evilscientress/ESP32-C3-UWB/hardware/ESP32 UWB bottom.png

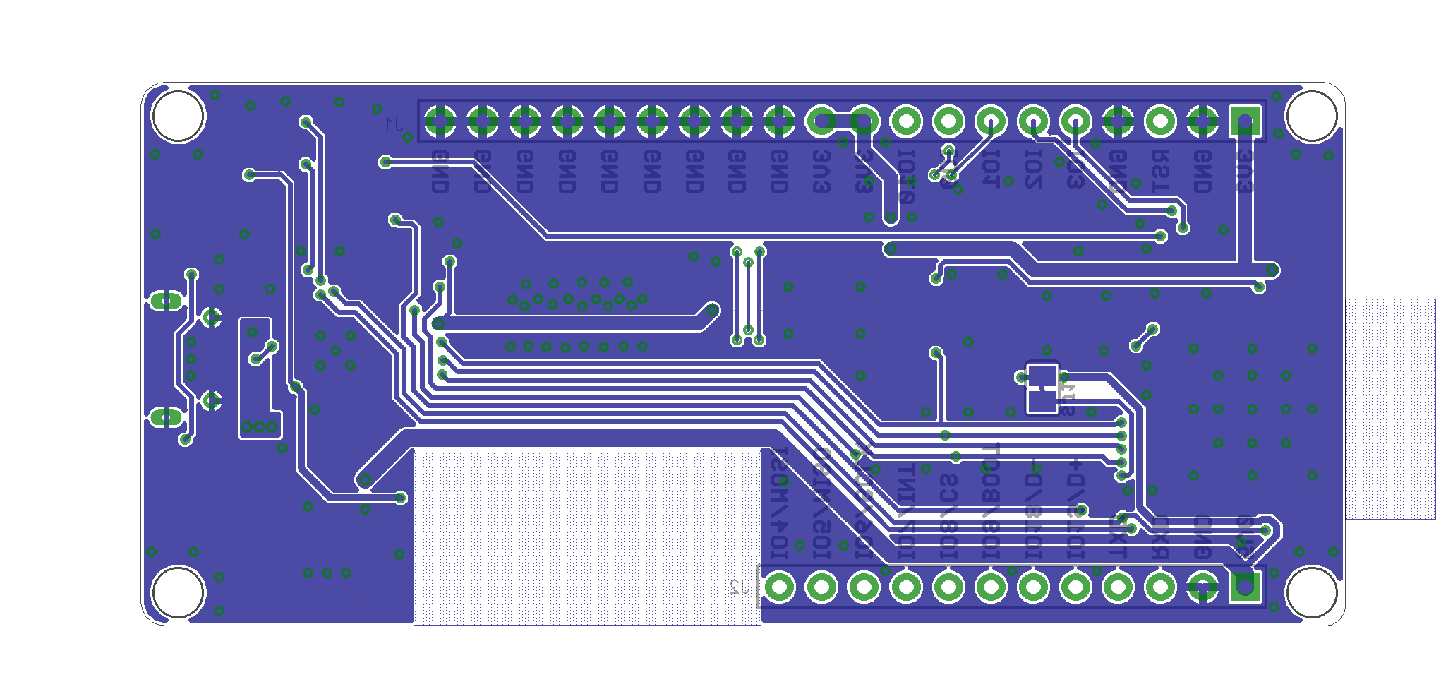
hardware/ESP32 UWB bottom.png
