evilscientress/ESP32-C3-UWB/hardware/ESP32 UWB top.png

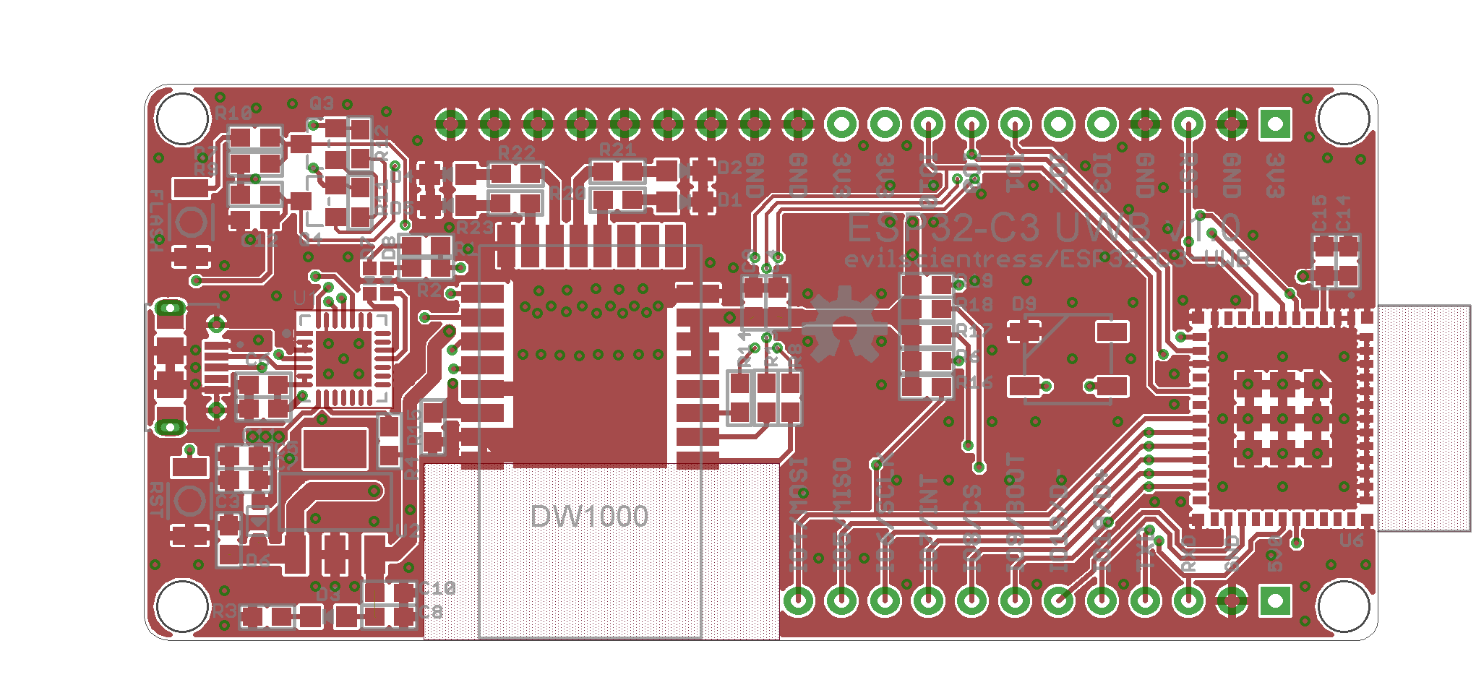
hardware/ESP32 UWB top.png
