evilscientress/ESP32-C3-UWB/hardware/ESP32 UWB No USB.pdf

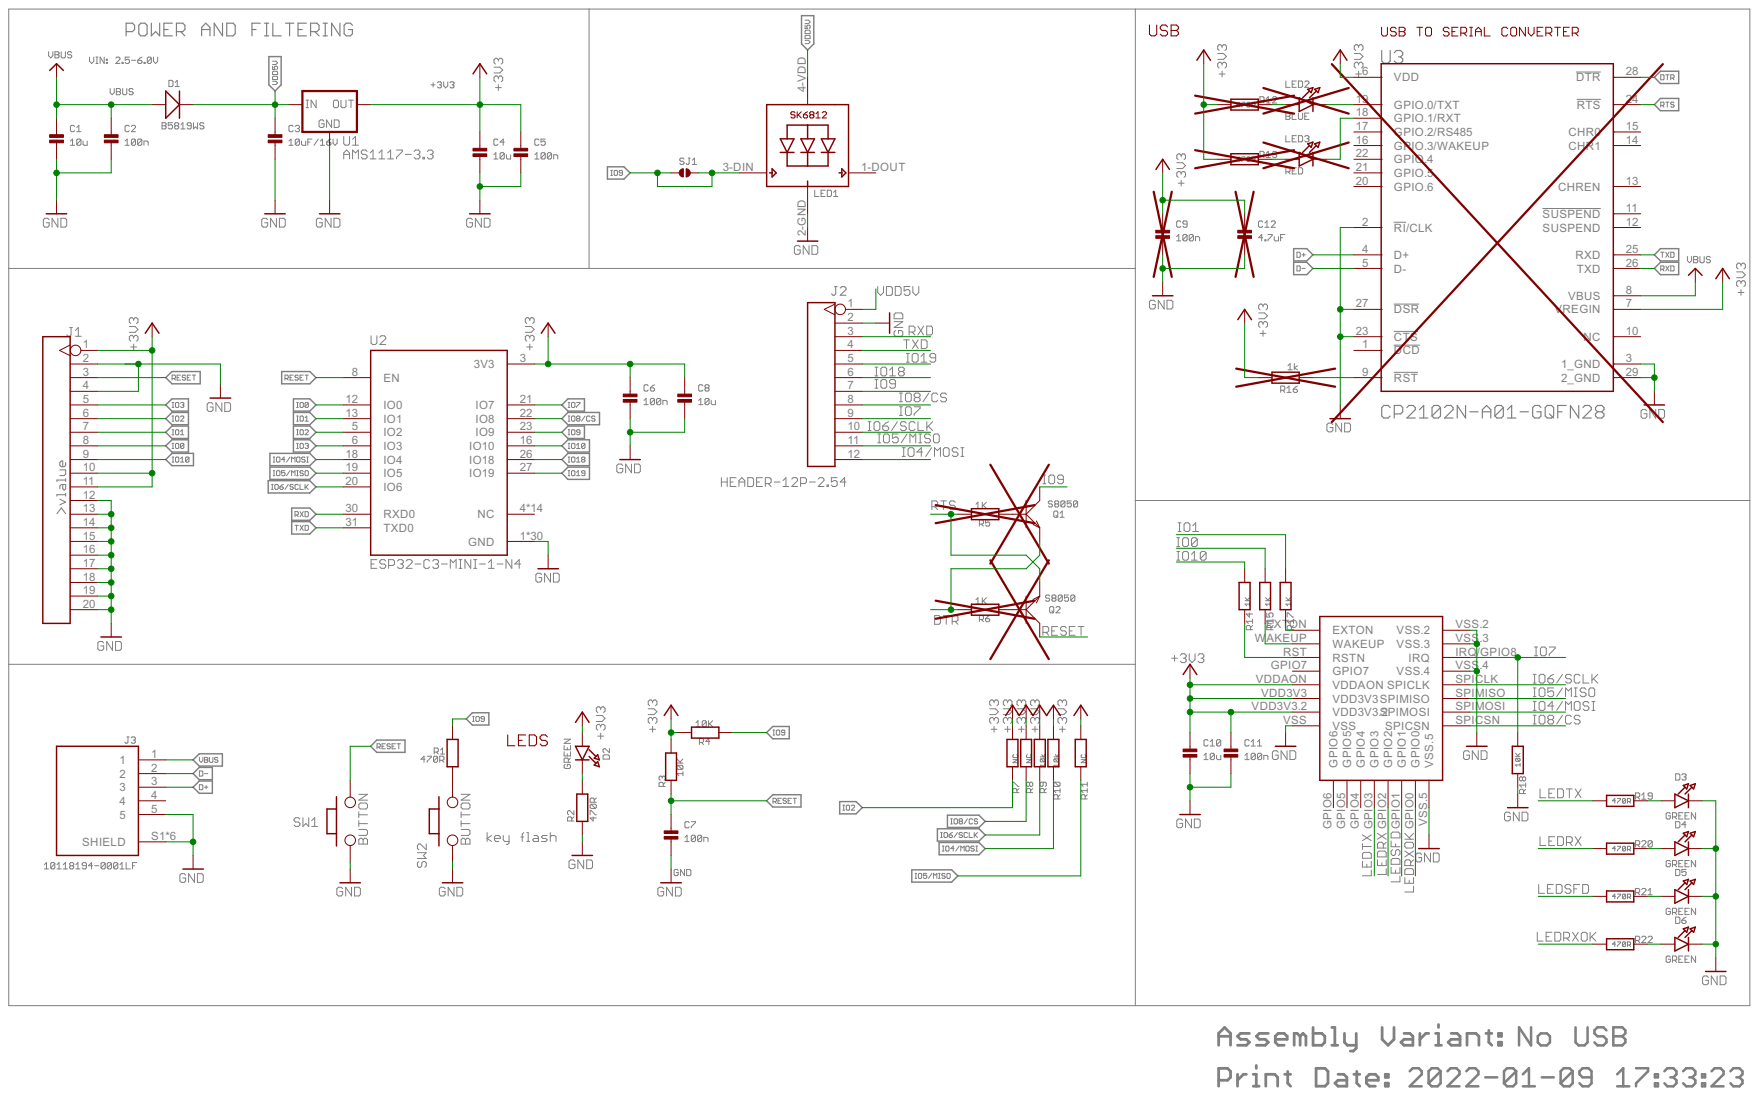
[picture p3: page 1]
