evilscientress/ESP32-C3-UWB/hardware/ESP32 UWB.pdf

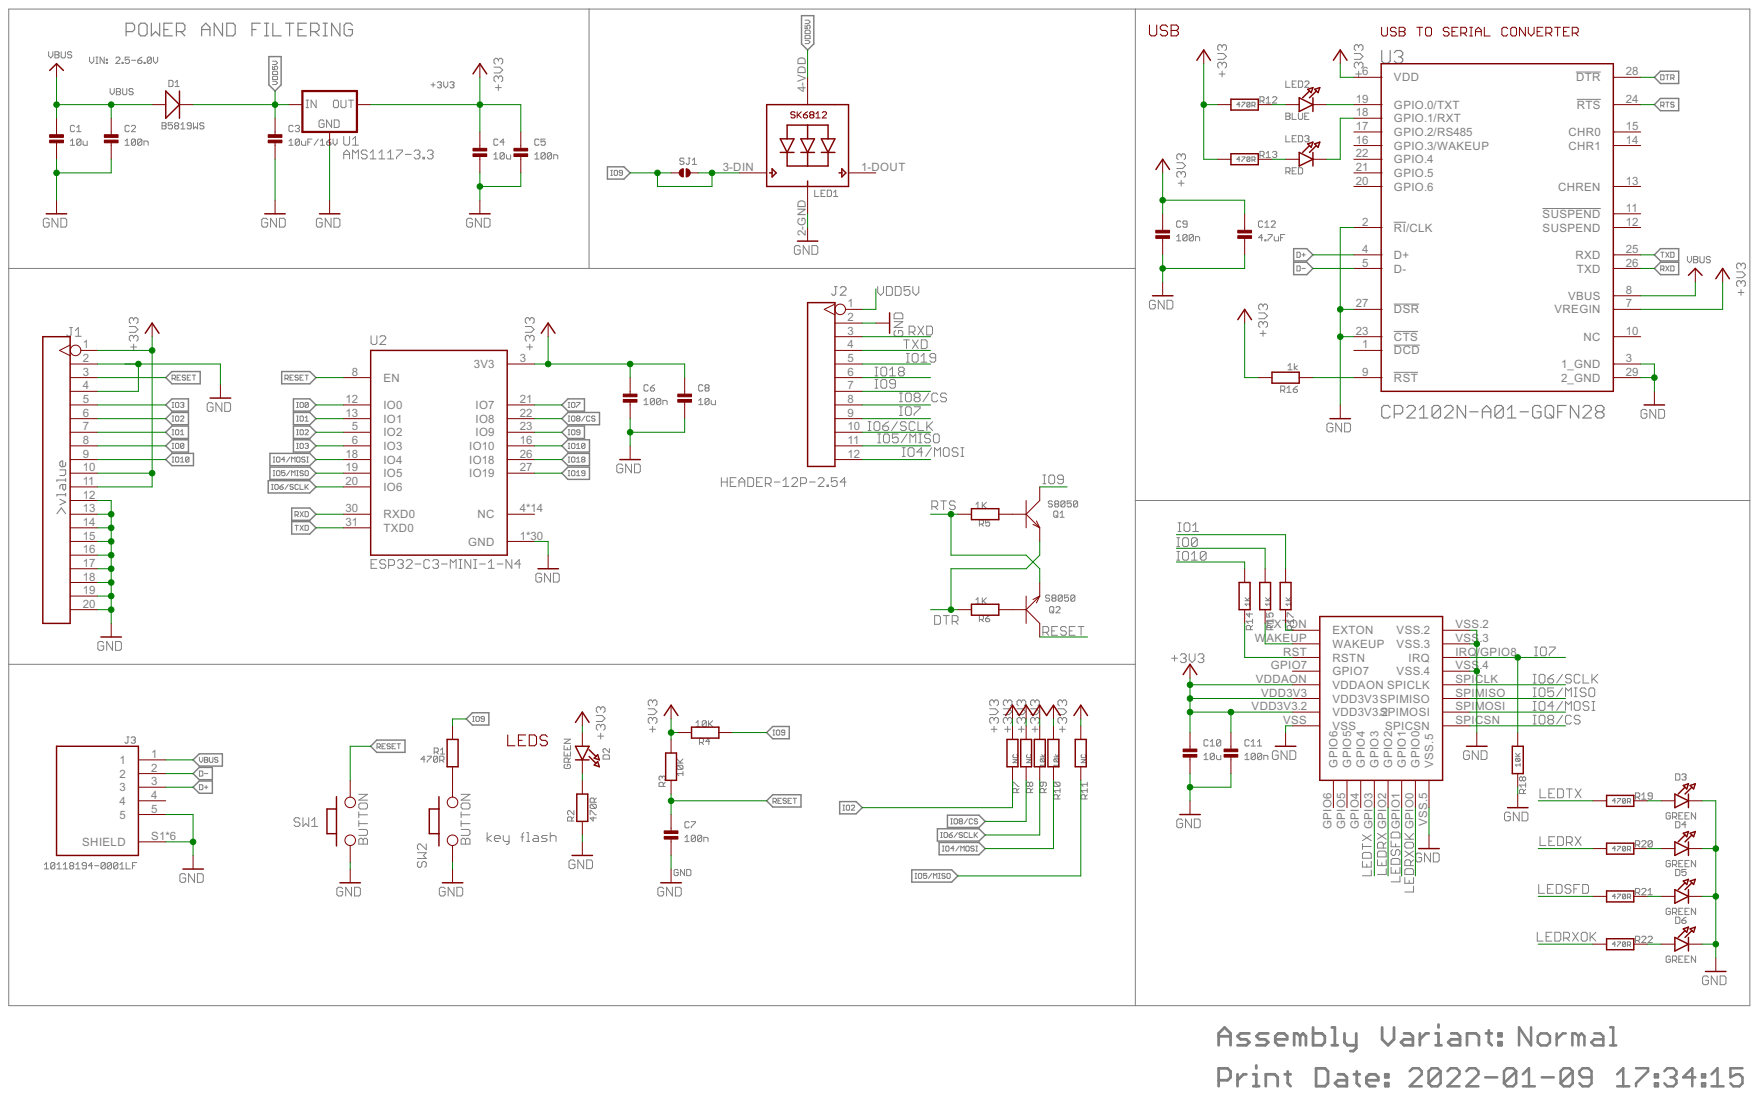
[picture p4: page 1]
