evilscientress/ESP32-C3-UWB/hardware/KiCad/ESP32 UWB.kicad_pcb

## KiCad design hardware/KiCad/ESP32 UWB.kicad_pcb (2022-01-16)

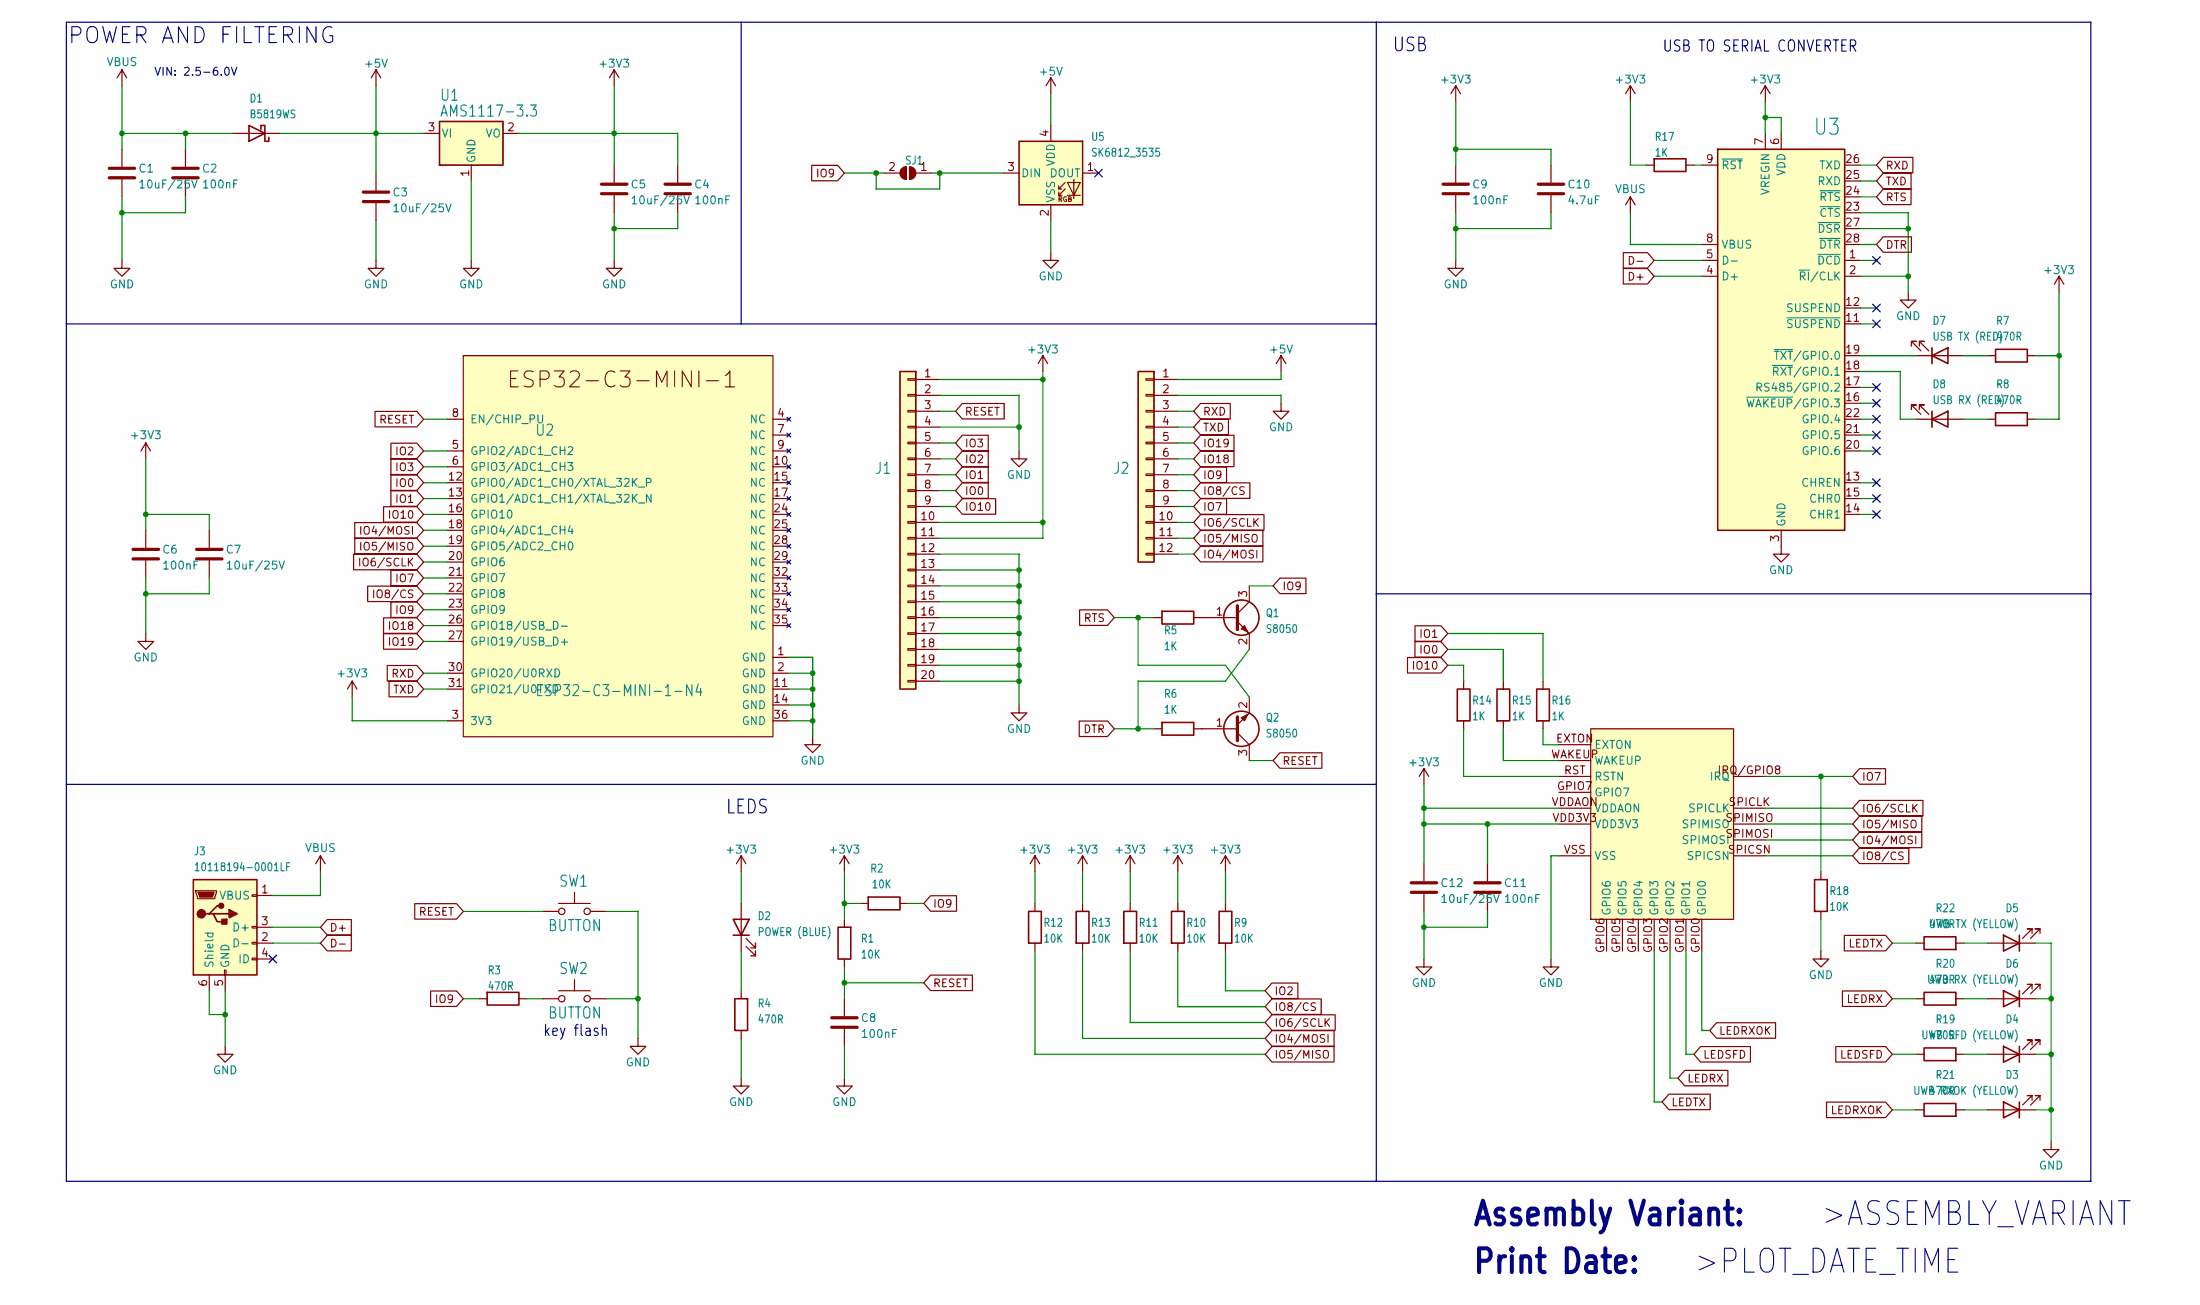
[picture p5: schematic ESP32 UWB.kicad_sch]

Parts:
C1, C3, C5, C7, C12: 10uF/25V; C_0603_1608Metric_Pad1.08x0.95mm_HandSolder; Part CL10X106MO8NRNC; LCSC C96446
C2, C4, C6, C8, C9, C11: 100nF; C_0603_1608Metric_Pad1.08x0.95mm_HandSolder; Part CL10B104KB8NNWC; LCSC C14663
C10: 4.7uF; C_0603_1608Metric_Pad1.08x0.95mm_HandSolder; Part CL10A475KO8NNNC; LCSC C19666
D1: B5819WS; D_SOD-323_HandSoldering; Part NSVR1020MW2T1G; LCSC C191023
D2: POWER (BLUE); LED_0805_2012Metric_Pad1.15x1.40mm_HandSolder; Part 150080BS75000; LCSC C2293
D3: UWB RXOK (YELLOW); LED_0805_2012Metric_Pad1.15x1.40mm_HandSolder; Part LY R976-PS-36; LCSC C2296
D4: UWB SFD (YELLOW); LED_0805_2012Metric_Pad1.15x1.40mm_HandSolder; Part LY R976-PS-36; LCSC C2296
D5: UWB TX (YELLOW); LED_0805_2012Metric_Pad1.15x1.40mm_HandSolder; Part LY R976-PS-36; LCSC C2296
D6: UWB RX (YELLOW); LED_0805_2012Metric_Pad1.15x1.40mm_HandSolder; Part LY R976-PS-36; LCSC C2296
D7: USB TX (RED); LED_0603_1608Metric_Pad1.05x0.95mm_HandSolder; Part SML-D12U1WT86; LCSC C2286
D8: USB RX (RED); LED_0603_1608Metric_Pad1.05x0.95mm_HandSolder; Part SML-D12U1WT86; LCSC C2286
J1: HEADER-20P-2.54; PinHeader_1x20_P2.54mm_Vertical; Part PH1-20-UA; LCSC C50981
J2: HEADER-12P-2.54; PinHeader_1x12_P2.54mm_Vertical; Part PH1-12-UA; LCSC C225487
J3: 10118194-0001LF; USB_Micro-B_Amphenol_10118194_Horizontal; Part 10118194-0001LF; LCSC C132563
Q1, Q2: S8050; SOT-23; Part SS8050-G; LCSC C2146
R1, R2, R9, R10, R11, R12, R13, R18: 10K; R_0603_1608Metric_Pad0.98x0.95mm_HandSolder; Part RMCF0603JT10K0; LCSC C25804
R3, R4, R7, R8, R19, R20, R21, R22: 470R; R_0603_1608Metric_Pad0.98x0.95mm_HandSolder; Part RMCF0603JT470R; LCSC C23179
R5, R6, R14, R15, R16, R17: 1K; R_0603_1608Metric_Pad0.98x0.95mm_HandSolder; Part RMCF0603JJ1K00; LCSC C21190
SJ1: SJS; SolderJumper-2_P1.3mm_Open_TrianglePad1.0x1.5mm
SW1, SW2: BUTTON; SW_Push_3x4mm; Part PTS820J15MSMTRLFS; LCSC C720477
U1: AMS1117-3.3; SOT-223-3_TabPin2; Part NCP1117LPST33T3G; LCSC C6186
U2: ESP32-C3-MINI-1-N4; ESP32-C3-MINI-1_Hand-Soldering; Part ESP32-C3-MINI-1-N4; LCSC C2838502
U3: SILICON_LABS_CP2102N-A01-GQFN28SILICON_LABS_CP210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; QFN-28-1EP_5x5mm_P0.5mm_EP3.35x3.35mm; Part CP2102N-A02-GQFN28; LCSC C6568
U4: BU01; Part BU01; LCSC C503604
U5: SK6812_3535; LED_SK6812MINI_PLCC4_3.5x3.5mm_P1.75mm; Part 2659

Connections:
+3V3: C4.1, C5.1, C6.1, C7.1, C9.1, C10.1, C11.1, C12.1, D2.2 (A), J1.1, J1.10, J1.11, R1.2, R2.2, R7.1, R8.1, R9.1, R10.1, R11.1, R12.1, R13.1, R17.2, U1.2 (VO), U2.3 (3V3), U3.6 (VDD), U3.7 (VREGIN), U4.VDD3V3, U4.VDDAON
+5V: C3.1, D1.1 (K), J2.1, U1.3 (VI), U5.4 (VDD)
D+: J3.3 (D+), U3.4 (D+)
D-: J3.2 (D-), U3.5 (D-)
DTR: Q1.2 (E), R6.2, U3.28 (~DTR)
GND: C1.2, C2.2, C3.2, C4.2, C5.2, C6.2, C7.2, C8.2, C9.2, C10.2, C11.2, C12.2, D3.1 (K), D4.1 (K), D5.1 (K), D6.1 (K), J1.2, J1.4, J1.12, J1.13, J1.14, J1.15, J1.16, J1.17, J1.18, J1.19, J1.20, J2.2, J3.5 (GND), J3.6 (Shield), R4.1, R18.2, SW1.2, SW2.2, U1.1 (GND), U2.1 (GND), U2.2 (GND), U2.11 (GND), U2.14 (GND), U2.36 (GND), U3.2 (~RI/CLK), U3.3 (GND), U3.23 (~CTS), U3.27 (~DSR), U3.29 (GND), U4.VSS, U5.2 (VSS)
IO0: J1.8, R15.1, U2.12 (GPIO0/ADC1_CH0/XTAL_32K_P)
IO1: J1.7, R16.1, U2.13 (GPIO1/ADC1_CH1/XTAL_32K_N)
IO2: J1.6, R9.2, U2.5 (GPIO2/ADC1_CH2)
IO3: J1.5, U2.6 (GPIO3/ADC1_CH3)
IO4/MOSI: J2.12, R13.2, U2.18 (GPIO4/ADC1_CH4), U4.SPIMOSI
IO5/MISO: J2.11, R12.2, U2.19 (GPIO5/ADC2_CH0), U4.SPIMISO
IO6/SCLK: J2.10, R11.2, U2.20 (GPIO6), U4.SPICLK
IO7: J2.9, R18.1, U2.21 (GPIO7), U4.IRQ/GPIO8 (IRQ)
IO8/CS: J2.8, R10.2, U2.22 (GPIO8), U4.SPICSN
IO9: J2.7, Q1.3 (C), R2.1, R3.2, SJ1.1 (A), SJ1.2 (B), U2.23 (GPIO9), U5.3 (DIN)
IO10: J1.9, R14.1, U2.16 (GPIO10)
IO18: J2.6, U2.26 (GPIO18/USB_D-)
IO19: J2.5, U2.27 (GPIO19/USB_D+)
LEDRX: R20.1, U4.GPIO2
LEDRXOK: R21.1, U4.GPIO0
LEDSFD: R19.1, U4.GPIO1
LEDTX: R22.1, U4.GPIO3
unnamed: D2.1 (K), R4.2
unnamed: D3.2 (A), R21.2
unnamed: D4.2 (A), R19.2
unnamed: D5.2 (A), R22.2
unnamed: D6.2 (A), R20.2
unnamed: D7.1 (K), U3.19 (~TXT/GPIO.0)
unnamed: D7.2 (A), R7.2
unnamed: D8.1 (K), U3.18 (~RXT/GPIO.1)
unnamed: D8.2 (A), R8.2
unnamed: Q1.1 (B), R5.1
unnamed: Q2.1 (B), R6.1
unnamed: R3.1, SW2.1
unnamed: R14.2, U4.RST (RSTN)
unnamed: R15.2, U4.WAKEUP
unnamed: R16.2, U4.EXTON
unnamed: R17.1, U3.9 (~RST)
RESET: C8.1, J1.3, Q2.3 (C), R1.1, SW1.1, U2.8 (EN/CHIP_PU)
RTS: Q2.2 (E), R5.2, U3.24 (~RTS)
RXD: J2.3, U2.30 (GPIO20/U0RXD), U3.26 (TXD)
TXD: J2.4, U2.31 (GPIO21/U0TXD), U3.25 (RXD)
VBUS: C1.1, C2.1, D1.2 (A), J3.1 (VBUS), U3.8 (VBUS)

Notes on the sheet:
VIN: 2.5-6.0V
>PLOT_DATE_TIME
LEDS
USB TO SERIAL CONVERTER
Assembly Variant:
Print Date:
>ASSEMBLY_VARIANT
USB
key flash
POWER AND FILTERING

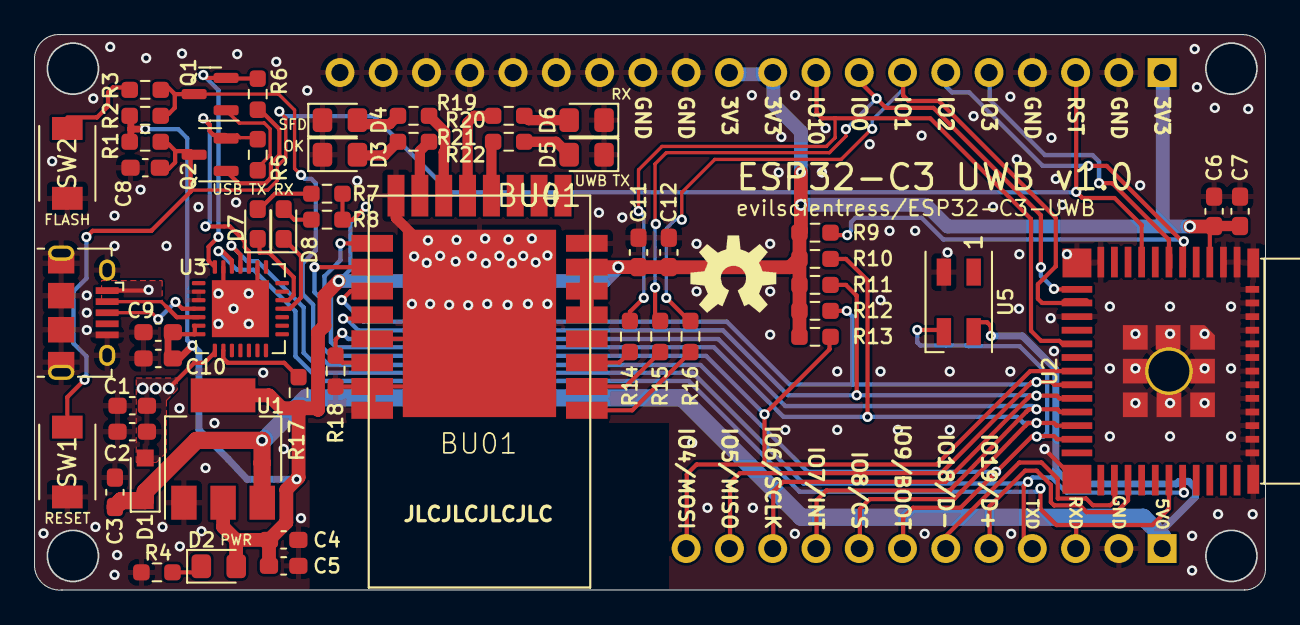
[picture p6: board ESP32 UWB.kicad_pcb from above]

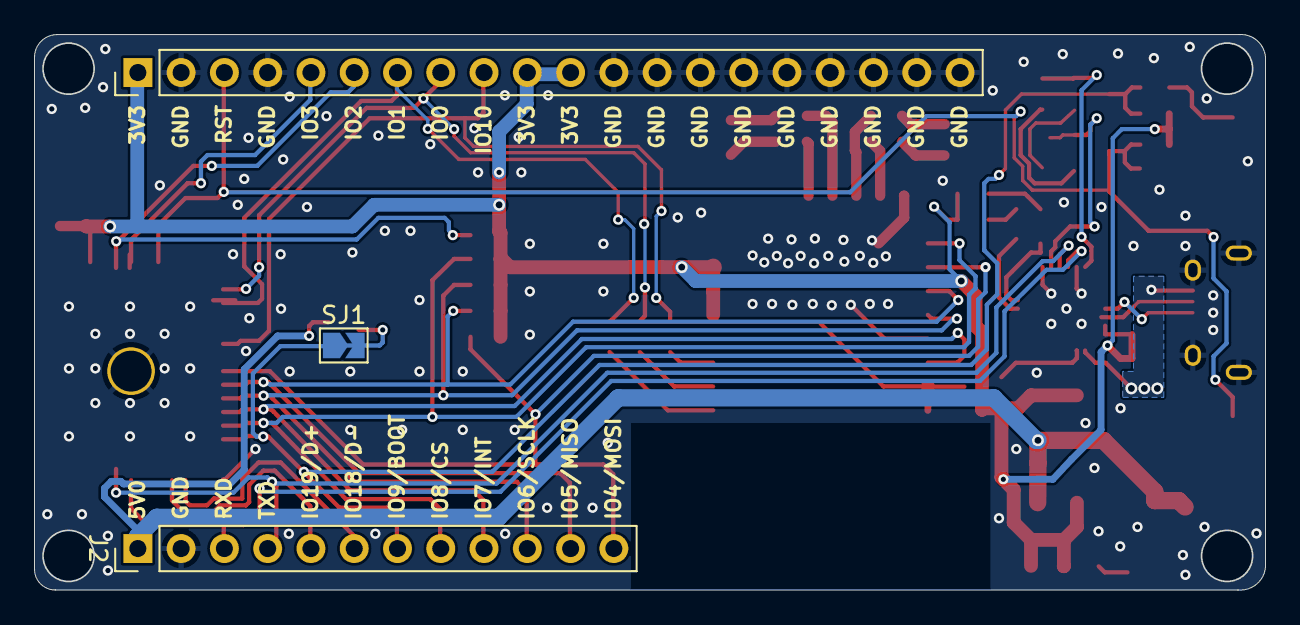
[picture p7: board ESP32 UWB.kicad_pcb from below]

Board: 2 copper layers, 72.3 x 32.6 mm, 56 parts (3 on the bottom side), 44 nets.

Other parts of the board:
U$1: OSHW-LOGO-M
