evilscientress/ESP32-C3-UWB/hardware/ESP32 UWB.brd

## EAGLE design hardware/ESP32 UWB.brd (2022-01-09)

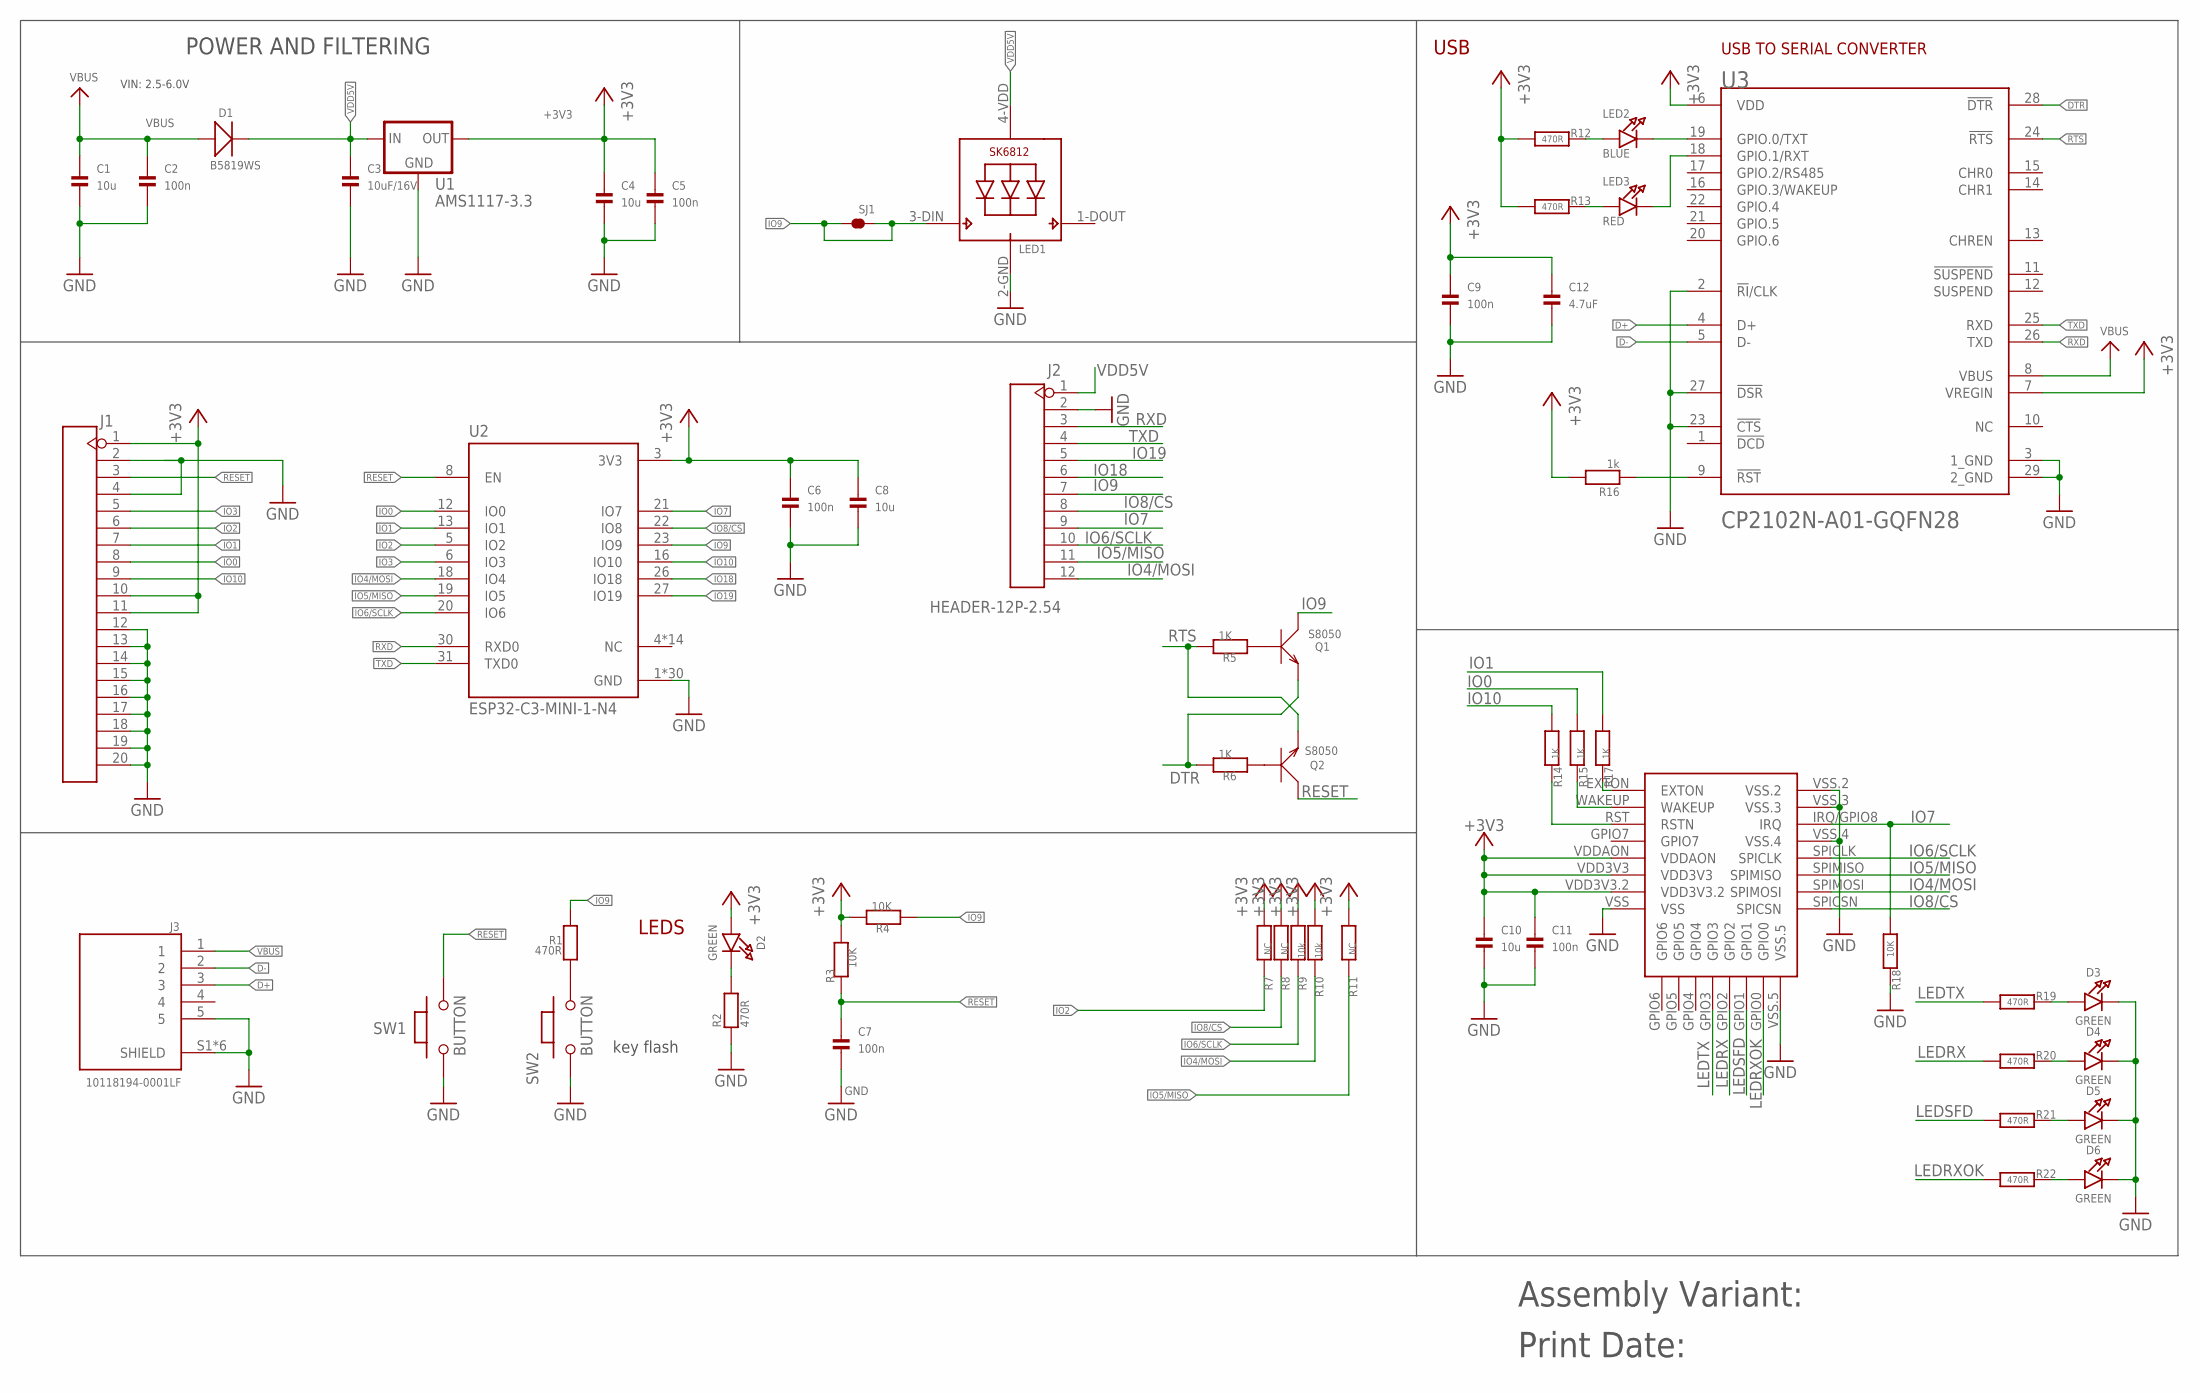
[picture p8: schematic ESP32 UWB.sch]

Parts:
C1, C4, C8, C10: 10u; 0603
C2, C5, C6, C7, C9, C11: 100n; 0603
C3: 10uF/16V; 0603
C12: 4.7uF; 0603
D1: B5819WS; SOD323
D2, D3, D4, D5, D6: GREEN; CHIPLED_0805_NOOUTLINE
J1: HEADER-20P-2.54; 20P-2.54
J2: HEADER-12P-2.54; 12P-2.54
J3: 10118194-0001LF; AMPHENOL_10118194-0001LF
LED1: SK6812_3535; LED3535
LED2: BLUE; CHIPLED_0603_NOOUTLINE
LED3: RED; CHIPLED_0603_NOOUTLINE
Q1, Q2: S8050; SOT23
R1, R2, R12, R13, R19, R20, R21, R22: 470R; 0603
R3, R4, R18: 10K; 0603
R5, R6, R14, R15, R17: 1K; 0603
R7, R8, R11: NC; 0603
R9, R10: 10k; 0603
R16: 1k; 0603
SJ1: SJS; SJ_S
SW1, SW2: BUTTON; 157SW
U1: AMS1117-3.3; SOT223
U2: ESP32-C3-MINI-1-N4; XCVR_ESP32-C3-MINI-1-N4
U3: SILICON_LABS_CP2102N-A01-GQFN28SILICON_LABS_CP210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; SILICON_LABS_CP2102N-A01-GQFN28_3
U4: DWM1000

Connections:
+3V3: C4.1, C5.1, C6.1, C8.1, C9.1, C10.1, C11.1, C12.1, D2.A, J1.1, J1.10, J1.11, R3.2, R4.2, R7.1, R8.1, R9.1, R10.1, R11.1, R12.1, R13.1, R16.2, U1.3 (OUT), U2.3 (3V3), U3.6 (VDD), U3.7 (VREGIN), U4.VDD3V3, U4.VDD3V3.2, U4.VDDAON
D+: J3.3, U3.4 (D+)
D-: J3.2, U3.5 (D-)
DTR: Q1.2 (E), R6.2, U3.28 (!DTR!)
GND: C1.2, C2.2, C3.2, C4.2, C5.2, C6.2, C7.2, C8.2, C9.2, C10.2, C11.2, C12.2, D3.C, D4.C, D5.C, D6.C, J1.2, J1.4, J1.12, J1.13, J1.14, J1.15, J1.16, J1.17, J1.18, J1.19, J1.20, J2.2, J3.5, J3.S1 (SHIELD), J3.S2 (SHIELD), J3.S3 (SHIELD), J3.S4 (SHIELD), J3.S5 (SHIELD), J3.S6 (SHIELD), LED1.2-GND (GND), R2.1, R18.2, SW1.1, SW2.1, U1.2 (GND), U2.1 (GND), U2.2 (GND), U2.11 (GND), U2.14 (GND), U2.36 (GND), U2.37 (GND), U2.38 (GND), U2.39 (GND), U2.40 (GND), U2.41 (GND), U2.42 (GND), U2.43 (GND), U2.44 (GND), U2.45 (GND), U2.46 (GND), U2.47 (GND), U2.48 (GND), U2.49_1 (GND), U2.49_2 (GND), U2.49_3 (GND), U2.49_4 (GND), U2.49_5 (GND), U2.49_6 (GND), U2.49_7 (GND), U2.49_8 (GND), U2.49_9 (GND), U2.50 (GND), U2.51 (GND), U2.52 (GND), U2.53 (GND), U3.2 (!RI!/CLK), U3.3 (1_GND), U3.23 (!CTS!), U3.27 (!DSR!), U3.29 (2_GND), U4.VSS, U4.VSS.2, U4.VSS.3, U4.VSS.4, U4.VSS.5
IO0: J1.8, R15.1, U2.12 (IO0)
IO1: J1.7, R17.1, U2.13 (IO1)
IO2: J1.6, R7.2, U2.5 (IO2)
IO3: J1.5, U2.6 (IO3)
IO4/MOSI: J2.12, R10.2, U2.18 (IO4), U4.SPIMOSI
IO5/MISO: J2.11, R11.2, U2.19 (IO5), U4.SPIMISO
IO6/SCLK: J2.10, R9.2, U2.20 (IO6), U4.SPICLK
IO7: J2.9, R18.1, U2.21 (IO7), U4.IRQ/GPIO8 (IRQ)
IO8/CS: J2.8, R8.2, U2.22 (IO8), U4.SPICSN
IO9: J2.7, LED1.3-DIN (DI), Q1.3 (C), R1.2, R4.1, SJ1.1, SJ1.2, U2.23 (IO9)
IO10: J1.9, R14.1, U2.16 (IO10)
IO18: J2.6, U2.26 (IO18)
IO19: J2.5, U2.27 (IO19)
LEDRX: R20.1, U4.GPIO2
LEDRXOK: R22.1, U4.GPIO0
LEDSFD: R21.1, U4.GPIO1
LEDTX: R19.1, U4.GPIO3
unnamed: D3.A, R19.2
unnamed: LED2.A, R12.2
unnamed: LED2.C, U3.19 (GPIO.0/TXT)
unnamed: LED3.A, R13.2
unnamed: D2.C, R2.2
unnamed: LED3.C, U3.18 (GPIO.1/RXT)
unnamed: R16.1, U3.9 (!RST!)
unnamed: R17.2, U4.EXTON
unnamed: R15.2, U4.WAKEUP
unnamed: R14.2, U4.RST (RSTN)
unnamed: Q2.1 (B), R6.1
unnamed: Q1.1 (B), R5.1
unnamed: R1.1, SW2.2
unnamed: D4.A, R20.2
unnamed: D5.A, R21.2
unnamed: D6.A, R22.2
RESET: C7.1, J1.3, Q2.3 (C), R3.1, SW1.2, U2.8 (EN)
RTS: Q2.2 (E), R5.2, U3.24 (!RTS!)
RXD: J2.3, U2.30 (RXD0), U3.26 (TXD)
TXD: J2.4, U2.31 (TXD0), U3.25 (RXD)
VBUS: C1.1, C2.1, D1.+, J3.1, U3.8 (VBUS)
VDD5V: C3.1, D1.-, J2.1, LED1.4-VDD (VDD), U1.1 (IN)

Notes on the sheet:
USB
LEDS
USB TO SERIAL CONVERTER
key flash
POWER AND FILTERING
VIN: 2.5-6.0V
Assembly Variant:
Print Date:

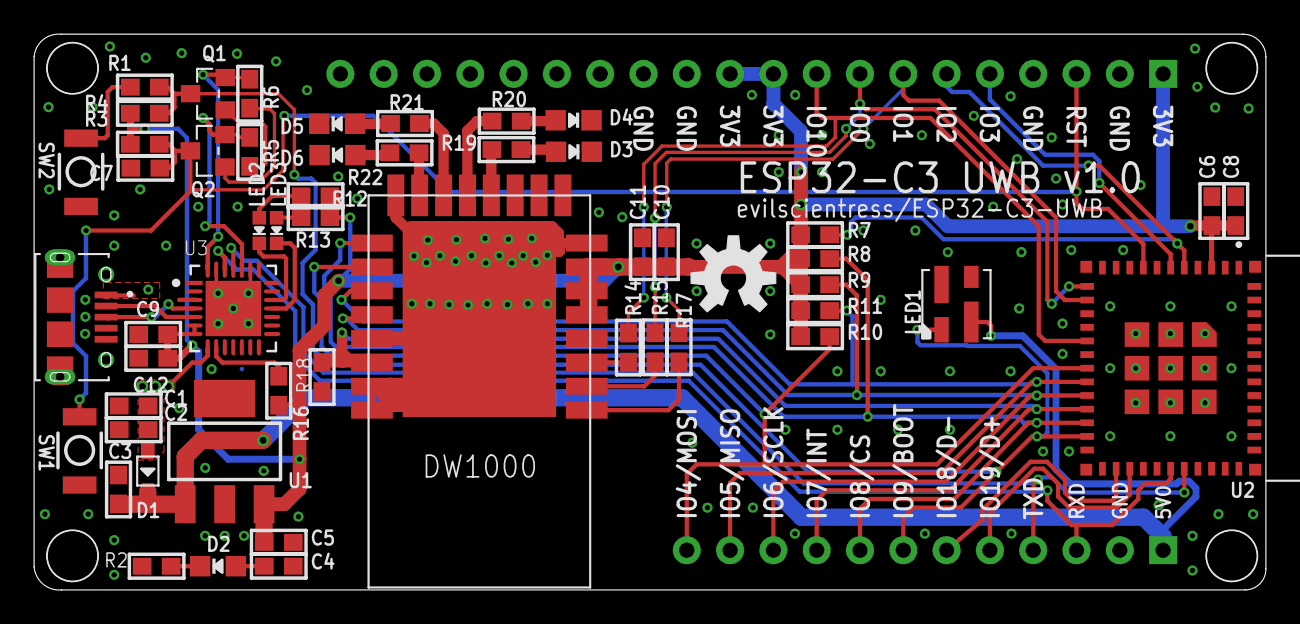
[picture p9: board ESP32 UWB.brd from above]

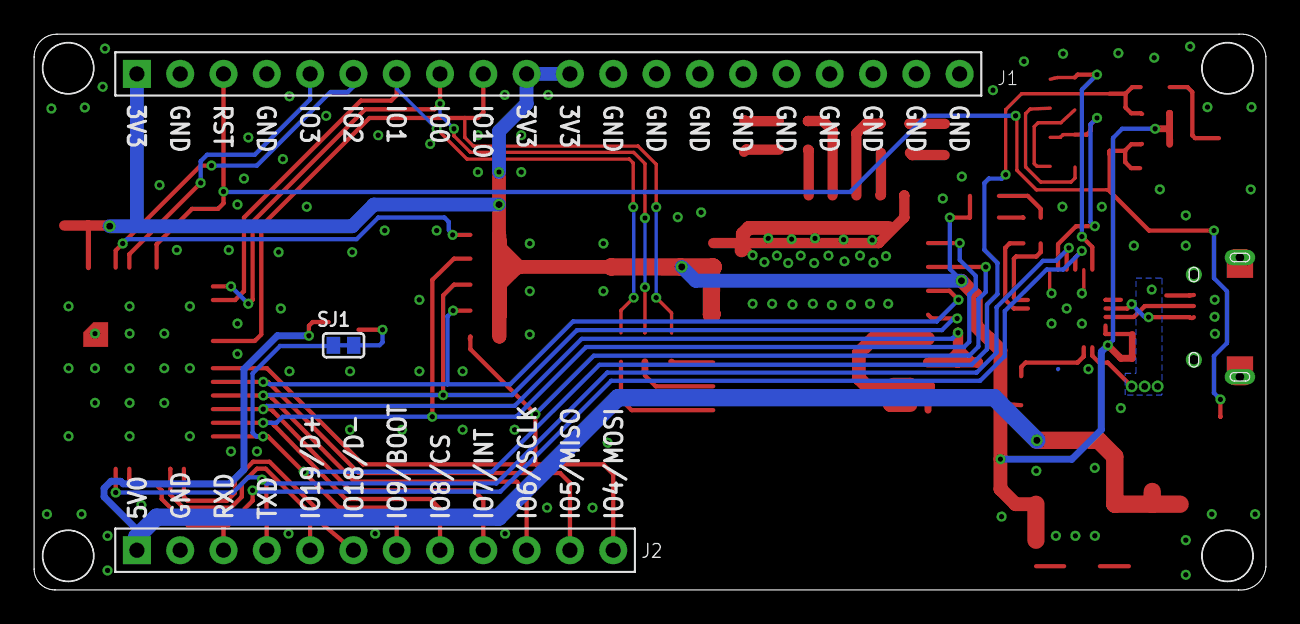
[picture p10: board ESP32 UWB.brd from below]

Board: 2 copper layers, 72.3 x 32.6 mm, 56 parts (3 on the bottom side), 44 nets.

Other parts of the board:
U$1: OSHW-LOGO-M
