evilscientress/ESP32-C3-UWB/(commit log)

2022-01-05 swaped ESP module to ESP32-C3-MINI
    [ESP32 UWB v1.0.brd, ESP32 UWB v1.0.sch]
2022-01-05 schematic cleanup and pdf export
    [ESP32 UWB v1.0.sch]
2022-01-05 renamed pcb files, updated gerber package
    [ESP32 UWB.brd, ESP32 UWB.sch]
2022-01-06 switched various parts to more newer or more available part, moved all to the front
    Switched Parts:
    * USB-Serial Converter CP2104 -> CP2102N
    * 3.3V LDO
    * Micro USB Connector
    All parts are now on the front side which means expensive double sided assembly is no longer needed.
    [ESP32 UWB.brd, ESP32 UWB.sch]
2022-01-06 switched resistor and capacitor footprints, placed labels
    [ESP32 UWB.brd, ESP32 UWB.sch]
2022-01-06 Added WS2812b led for status display
    [ESP32 UWB.brd, ESP32 UWB.sch]
2022-01-06 fixed floating input pins
    [ESP32 UWB.brd, ESP32 UWB.sch]
2022-01-06 added solder jumper for optionally disabling the ws2812 led
    [ESP32 UWB.brd, ESP32 UWB.sch]
2022-01-06 updated gerber files and schematic pdf
2022-01-06 added images of top and bottom of the pcb
2022-01-07 Updated SJ Package to my own (smaller) version
    [ESP32 UWB.brd, ESP32 UWB.sch]
2022-01-07 fixed device prefixes, removed duplicate supply symbols
    [ESP32 UWB.sch]
2022-01-07 renumbered parts
    [ESP32 UWB.brd, ESP32 UWB.sch]
2022-01-07 replaced footprint of C7
    [ESP32 UWB.brd, ESP32 UWB.sch]
2022-01-07 updated library
    [ESP32 UWB.sch]
2022-01-07 replaced WS2812 with SK6812-mini-e
    [ESP32 UWB.brd, ESP32 UWB.sch]
2022-01-07 added production files (gerber, bom, cpl) for latest version
    [ESP32 UWB_top_bom.csv, ESP32 UWB_top_bom.ods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]
2022-01-09 fixed schematic pdf
2022-01-09 added assembly variant without USB serial converter
    [ESP32 UWB.brd, ESP32 UWB.sch]
2022-01-09 add version converted to KiCad
    [ESP32 UWB.kicad_pcb, ESP32 UWB.kicad_sch]
2022-01-15 update schematic to use built-in kicad symbols
    [ESP32 UWB.kicad_pcb, ESP32 UWB.kicad_sch]
2022-01-15 change all footprints in schematic
    [ESP32 UWB.kicad_sch]
2022-01-15 fox pcb
    [ESP32 UWB.kicad_pcb, ESP32 UWB.kicad_sch]
2022-01-15 tweak pcb and fix all DRC errors
    [ESP32 UWB.kicad_pcb]
2022-01-15 first silkscreen tweaks
    [ESP32 UWB.kicad_pcb]
2022-01-15 more tweaks
    [ESP32 UWB.kicad_pcb, ESP32 UWB.kicad_sch]
2022-01-15 tweak silkscreen and 3d model
    [ESP32 UWB.kicad_pcb, ESP32 UWB.kicad_sch]
2022-01-15 tweak silkscreen orientation and more
    [ESP32 UWB.kicad_pcb]
2022-01-15 swap pushbuttons
    [ESP32 UWB.kicad_pcb, ESP32 UWB.kicad_sch]
2022-01-15 clean up schematic
    [ESP32 UWB.kicad_sch]
2022-01-15 add keepout zone and labels for LEDs
    [ESP32 UWB.kicad_pcb, ESP32 UWB.kicad_sch]
2022-01-15 make DRC happy
    [ESP32 UWB.kicad_pcb]
2022-01-15 add kicad gitignore
2022-01-15 remove unused symbols and footprints
2022-01-16 further cleanup and improvment of the KiCad version of the PCB
    [ESP32 UWB.kicad_pcb, ESP32 UWB.kicad_sch]
2022-01-16 label buttons
    [ESP32 UWB.kicad_pcb]
2022-01-16 add JLCJLCJLCJLC
    [ESP32 UWB.kicad_pcb]
2022-01-16 adjust silkscreen
    [ESP32 UWB.kicad_pcb]
2022-01-16 add BOM fields and tweak symbols and parts
    [ESP32 UWB BOM.csv, ESP32 UWB.kicad_pcb, ESP32 UWB.kicad_sch]
2022-01-16 tweak bom some more
    [ESP32 UWB BOM.csv, ESP32 UWB.kicad_pcb, ESP32 UWB.kicad_sch]
2022-01-16 add files for JLCPCB
    [ESP32 UWB-B_Cu.gbl, ESP32 UWB-B_Mask.gbs, ESP32 UWB-B_Paste.gbp, ESP32 UWB-B_Silkscreen.gbo, ESP32 UWB-Edge_Cuts.gm1, ESP32 UWB-F_Cu.gtl, ESP32 UWB-F_Mask.gts, ESP32 UWB-F_Paste.gtp]
2022-01-16 more fabrication files
    [ESP32 UWB-all-pos.csv]
